Lshaw04/4180-Final-Project/(list of files, drawings)

Other design files:
FritizingSketchLDS.fzz
LukeShaw_Diagram.fzz
